RTimothyEdwards/sg13cmos5l_ocd_openframe/xschem/simulations/openframe_user_project.spice

** sch_path: /home/tim/gits/sg13cmos5l_ocd_openframe/xschem/openframe_user_project.sch
**.subckt openframe_user_project vddio vssio vccd vssd gpio0_ena gpio0_zero gpio0_out gpio1_ena gpio1_zero gpio1_out UART_Rx_zero
*+ UART_Rx_ena ref_in vbg UART_Rx_out UART_Tx_zero UART_Tx_ena UART_Tx_out spi_SDI_zero spi_SDI_ena spi_SDI_out test_source_ibias spi_CSB_zero
*+ spi_CSB_ena voltgen_vout1 spi_CSB_out idac1_source idac1_sink spi_SCK_zero spi_SCK_ena idac2_source voltgen_vout2 idac2_sink spi_SCK_out
*+ flash_csb_zero flash_csb_ena flash_csb_out flash_clk_ena flash_clk_zero flash_clk_out flash_io0_zero flash_io0_ena flash_io0_out resetb_in
*+ spi_SCK_in spi_SDO_out flash_io1_zero flash_io1_ena spi_SDI_in spi_CSB_in spi_SDO_ena flash_io1_out
*+ mask_rev[31],mask_rev[30],mask_rev[29],mask_rev[28],mask_rev[27],mask_rev[26],mask_rev[25],mask_rev[24],mask_rev[23],mask_rev[22],mask_rev[21],mask_rev[20],mask_rev[19],mask_rev[18],mask_rev[17],mask_rev[16],mask_rev[15],mask_rev[14],mask_rev[13],mask_rev[12],mask_rev[11],mask_rev[10],mask_rev[9],mask_rev[8],mask_rev[7],mask_rev[6],mask_rev[5],mask_rev[4],mask_rev[3],mask_rev[2],mask_rev[1],mask_rev[0] flash_io2_zero flash_io2_ena flash_io2_out flash_io3_zero flash_io3_ena flash_io3_out spi_SDO_one spi_SDO_zero flash_io3_one
*.iopin vddio
*.iopin vssio
*.iopin vccd
*.iopin vssd
*.ipin resetb_in
*.ipin
*+ mask_rev[31],mask_rev[30],mask_rev[29],mask_rev[28],mask_rev[27],mask_rev[26],mask_rev[25],mask_rev[24],mask_rev[23],mask_rev[22],mask_rev[21],mask_rev[20],mask_rev[19],mask_rev[18],mask_rev[17],mask_rev[16],mask_rev[15],mask_rev[14],mask_rev[13],mask_rev[12],mask_rev[11],mask_rev[10],mask_rev[9],mask_rev[8],mask_rev[7],mask_rev[6],mask_rev[5],mask_rev[4],mask_rev[3],mask_rev[2],mask_rev[1],mask_rev[0]
*.opin spi_SDO_out
*.opin spi_SDO_ena
*.opin spi_SDI_ena
*.opin spi_SDI_out
*.ipin spi_SDI_zero
*.ipin spi_SDI_in
*.opin spi_CSB_ena
*.opin spi_CSB_out
*.ipin spi_CSB_zero
*.ipin spi_CSB_in
*.opin spi_SCK_ena
*.opin spi_SCK_out
*.ipin spi_SCK_zero
*.ipin spi_SCK_in
*.opin vbg
*.ipin ref_in
*.ipin idac1_sink
*.ipin idac2_sink
*.opin idac1_source
*.opin idac2_source
*.opin test_source_ibias
*.opin voltgen_vout1
*.opin voltgen_vout2
*.ipin spi_SDO_one
*.ipin spi_SDO_zero
*.ipin flash_io3_one
*.opin gpio1_ena
*.opin gpio1_out
*.ipin gpio1_zero
*.opin UART_Rx_ena
*.opin UART_Rx_out
*.ipin UART_Rx_zero
*.opin UART_Tx_ena
*.opin UART_Tx_out
*.ipin UART_Tx_zero
*.opin gpio0_ena
*.opin gpio0_out
*.ipin gpio0_zero
*.opin flash_csb_ena
*.opin flash_csb_out
*.ipin flash_csb_zero
*.opin flash_clk_ena
*.opin flash_clk_out
*.ipin flash_clk_zero
*.opin flash_io0_ena
*.opin flash_io0_out
*.ipin flash_io0_zero
*.opin flash_io1_ena
*.opin flash_io1_out
*.ipin flash_io1_zero
*.opin flash_io2_ena
*.opin flash_io2_out
*.ipin flash_io2_zero
*.opin flash_io3_ena
*.opin flash_io3_out
*.ipin flash_io3_zero
x1 control[80] vddio vssio vssd vccd vdda7 power_stage
x2 control[79] vddio vssio vssd vccd vdda6 power_stage
x3 control[78] vddio vssio vssd vccd vdda5 power_stage
x4 control[77] vddio vssio vssd vccd vdda4 power_stage
x5 control[76] vddio vssio vssd vccd vdda3 power_stage
x6 control[75] vddio vssio vssd vccd vdda2 power_stage
x7 control[74] vddio vssio vssd vccd vdda1 power_stage
x8 control[21] vddio vssio vssd vccd vdda10 power_stage
x9 control[22] vddio vssio vssd vccd vdda11 power_stage
x10 control[23] vddio vssio vssd vccd vdda12 power_stage
x11 control[24] vddio vssio vssd vccd vdda13 power_stage
x12 control[25] vddio vssio vssd vccd vdda14 power_stage
x13 control[26] vddio vssio vssd vccd vdda15 power_stage
x14 control[27] vddio vssio vssd vccd vdda16 power_stage
x15 vdda12 vbg vssio net2 control[29] control[30] control[31] control[32] control[33] control[34] control[35] control[36]
+ control[37] control[38] control[39] control[40] control[41] control[42] control[43] control[44] vssd vccd control[28] net1
+ sg13cmos5l_ocd_ip__bandgap
x16 control[88] vddio vssio ref_in vccd vbg control[87] vssd net1 control[71] control[72] control[73] control[82] control[83]
+ control[107] control[106] control[105] control[104] control[103] control[58] control[59] control[60] control[61] control[62] net2 control[45]
+ control[46] control[47] control[48] control[49] control[121] control[120] control[119] control[118] control[117] net5 control[94] control[93]
+ control[92] control[91] control[90] test_source_ibias control[63] control[64] control[65] control[66] control[67] control[68] control[69]
+ control[70] net3 net4 idac1_source idac2_source control[102] control[101] control[100] control[99] control[98] control[97] control[96]
+ control[95] control[50] control[51] control[52] control[53] control[54] control[55] control[56] control[57] control[115] control[114]
+ control[113] control[112] control[111] control[110] control[109] control[108] idac1_sink idac2_sink control[86] control[85]
+ sg13cmos5l_ocd_ip__biasgen1
x17 vccd vssd vdda5 control[116] control[122] control[123] vbg vssio net5 voltgen_vout2 net3 control[124] voltgen_vout1
+ control[126] control[125] net4 control[127] sg13cmos5l_ocd_ip__voltgen
x18 spi_SDI_in mask_rev[31] mask_rev[30] mask_rev[29] mask_rev[28] mask_rev[27] mask_rev[26] mask_rev[25] mask_rev[24]
+ mask_rev[23] mask_rev[22] mask_rev[21] mask_rev[20] mask_rev[19] mask_rev[18] mask_rev[17] mask_rev[16] mask_rev[15] mask_rev[14] mask_rev[13]
+ mask_rev[12] mask_rev[11] mask_rev[10] mask_rev[9] mask_rev[8] mask_rev[7] mask_rev[6] mask_rev[5] mask_rev[4] mask_rev[3] mask_rev[2]
+ mask_rev[1] mask_rev[0] spi_CSB_in flash_io3_zero flash_io3_zero flash_io3_zero flash_io3_zero flash_io3_zero flash_io3_zero flash_io3_zero
+ flash_io3_zero flash_io3_zero flash_io3_zero flash_io3_zero flash_io3_zero flash_io3_zero flash_io3_zero flash_io3_zero flash_io3_zero
+ flash_io3_zero flash_io3_zero flash_io3_zero flash_io3_zero flash_io3_zero flash_io3_zero flash_io3_zero flash_io3_zero flash_io3_zero
+ flash_io3_zero flash_io3_zero flash_io3_zero flash_io3_zero flash_io3_zero flash_io3_zero flash_io3_zero flash_io3_one flash_io3_one
+ flash_io3_one flash_io3_one flash_io3_one flash_io3_one flash_io3_one flash_io3_one flash_io3_one flash_io3_one flash_io3_one flash_io3_one
+ flash_io3_one flash_io3_one flash_io3_one flash_io3_one flash_io3_one flash_io3_one flash_io3_one flash_io3_one flash_io3_one flash_io3_one
+ flash_io3_one flash_io3_one flash_io3_one flash_io3_one flash_io3_one flash_io3_one flash_io3_one flash_io3_one flash_io3_one flash_io3_one
+ spi_SDO_zero spi_SDO_zero spi_SDO_zero spi_SDO_zero spi_SDO_zero spi_SDO_zero spi_SDO_zero spi_SDO_zero spi_SDO_zero spi_SDO_zero spi_SDO_zero
+ spi_SDO_zero spi_SDO_zero spi_SDO_zero spi_SDO_zero spi_SDO_zero spi_SDO_zero spi_SDO_zero spi_SDO_zero spi_SDO_zero spi_SDO_zero spi_SDO_zero
+ spi_SDO_zero spi_SDO_zero spi_SDO_zero spi_SDO_zero spi_SDO_zero spi_SDO_zero spi_SDO_zero spi_SDO_zero spi_SDO_zero spi_SDO_zero spi_SDO_one
+ spi_SDO_one spi_SDO_one spi_SDO_one spi_SDO_one spi_SDO_one spi_SDO_one spi_SDO_one spi_SDO_one spi_SDO_one spi_SDO_one spi_SDO_one
+ spi_SDO_one spi_SDO_one spi_SDO_one spi_SDO_one spi_SDO_one spi_SDO_one spi_SDO_one spi_SDO_one spi_SDO_one spi_SDO_one spi_SDO_one
+ spi_SDO_one spi_SDO_one spi_SDO_one spi_SDO_one spi_SDO_one spi_SDO_one spi_SDO_one spi_SDO_one spi_SDO_one spi_SDO_out spi_SDO_ena vccd vssd
+ resetb_in net6 spi_SCK_in control[127] control[126] control[125] control[124] control[123] control[122] control[121] control[120]
+ control[119] control[118] control[117] control[116] control[115] control[114] control[113] control[112] control[111] control[110] control[109]
+ control[108] control[107] control[106] control[105] control[104] control[103] control[102] control[101] control[100] control[99] control[98]
+ control[97] control[96] control[95] control[94] control[93] control[92] control[91] control[90] control[89] control[88] control[87]
+ control[86] control[85] control[84] control[83] control[82] control[81] control[80] control[79] control[78] control[77] control[76]
+ control[75] control[74] control[73] control[72] control[71] control[70] control[69] control[68] control[67] control[66] control[65]
+ control[64] control[63] control[62] control[61] control[60] control[59] control[58] control[57] control[56] control[55] control[54]
+ control[53] control[52] control[51] control[50] control[49] control[48] control[47] control[46] control[45] control[44] control[43]
+ control[42] control[41] control[40] control[39] control[38] control[37] control[36] control[35] control[34] control[33] control[32]
+ control[31] control[30] control[29] control[28] control[27] control[26] control[25] control[24] control[23] control[22] control[21]
+ control[20] control[19] control[18] control[17] control[16] control[15] control[14] control[13] control[12] control[11] control[10]
+ control[9] control[8] control[7] control[6] control[5] control[4] control[3] control[2] control[1] control[0] housekeeping_top
* noconn #net6
* noconn control[19:0]
* noconn control[89]
* noconn control[84]
R1 gpio1_ena gpio1_zero 0.0293 m=1
R2 gpio1_out gpio1_zero 0.0293 m=1
R3 UART_Rx_ena UART_Rx_zero 0.0293 m=1
R4 UART_Rx_out UART_Rx_zero 0.0293 m=1
R5 UART_Tx_ena UART_Tx_zero 0.0293 m=1
R6 UART_Tx_out UART_Tx_zero 0.0293 m=1
R7 spi_SDI_ena spi_SDI_zero 0.0293 m=1
R8 spi_SDI_out spi_SDI_zero 0.0293 m=1
R9 spi_CSB_ena spi_CSB_zero 0.0293 m=1
R10 spi_CSB_out spi_CSB_zero 0.0293 m=1
R11 spi_SCK_ena spi_SCK_zero 0.0293 m=1
R12 spi_SCK_out spi_SCK_zero 0.0293 m=1
x19 control[81] vddio vssio vssd vccd vdda8 power_stage
x20 control[20] vddio vssio vssd vccd vdda9 power_stage
R13 gpio0_ena gpio0_zero 0.0293 m=1
R14 gpio0_out gpio0_zero 0.0293 m=1
R15 flash_csb_ena flash_csb_zero 0.0293 m=1
R16 flash_csb_out flash_csb_zero 0.0293 m=1
R17 flash_clk_ena flash_clk_zero 0.0293 m=1
R18 flash_clk_out flash_clk_zero 0.0293 m=1
R19 flash_io0_ena flash_io0_zero 0.0293 m=1
R20 flash_io0_out flash_io0_zero 0.0293 m=1
R21 flash_io1_ena flash_io1_zero 0.0293 m=1
R22 flash_io1_out flash_io1_zero 0.0293 m=1
R23 flash_io2_ena flash_io2_zero 0.0293 m=1
R24 flash_io2_out flash_io2_zero 0.0293 m=1
R25 flash_io3_ena flash_io3_zero 0.0293 m=1
R26 flash_io3_out flash_io3_zero 0.0293 m=1
**.ends

* expanding   symbol:  power_stage.sym # of pins=6
** sym_path: /home/tim/gits/sg13cmos5l_ocd_openframe/dependencies/sg13cmos5l_ocd_ip__analog_switches/xschem/power_stage.sym
** sch_path: /home/tim/gits/sg13cmos5l_ocd_openframe/dependencies/sg13cmos5l_ocd_ip__analog_switches/xschem/power_stage.sch
.subckt power_stage enable IOVDD_IN IOVSS DVSS DVDD IOVDD_OUT
*.ipin enable
*.ipin IOVDD_IN
*.ipin DVSS
*.ipin DVDD
*.ipin IOVSS
*.opin IOVDD_OUT
XM14 IOVDD_OUT P_DRIVE IOVDD_IN IOVDD_IN sg13_hv_pmos w=4.36u l=0.4u ng=1 m=760
x2 net1 net2 P_DRIVE IOVDD_IN IOVSS gate_drive
x1 net1 enable DVDD DVSS sg13cmos5l_inv_4
x3 net2 net1 DVDD DVSS sg13cmos5l_inv_4
x4[1] DVDD DVSS sg13cmos5l_decap_4
x4[0] DVDD DVSS sg13cmos5l_decap_4
x9 enable DVDD DVSS sg13cmos5l_antennanp
.ends


* expanding   symbol:  sg13cmos5l_ocd_ip__bandgap.sym # of pins=9
** sym_path: /home/tim/gits/sg13cmos5l_ocd_openframe/dependencies/sg13cmos5l_ocd_ip__biasgen/xschem/sg13cmos5l_ocd_ip__bandgap.sym
** sch_path: /home/tim/gits/sg13cmos5l_ocd_openframe/dependencies/sg13cmos5l_ocd_ip__biasgen/xschem/sg13cmos5l_ocd_ip__bandgap.sch
.subckt sg13cmos5l_ocd_ip__bandgap vdd vbg vss ibias1_250n trim[15] trim[14] trim[13] trim[12] trim[11] trim[10] trim[9] trim[8]
+ trim[7] trim[6] trim[5] trim[4] trim[3] trim[2] trim[1] trim[0] dvss dvdd ena ibias2_1u
*.ipin
*+ trim[15],trim[14],trim[13],trim[12],trim[11],trim[10],trim[9],trim[8],trim[7],trim[6],trim[5],trim[4],trim[3],trim[2],trim[1],trim[0]
*.ipin ena
*.opin vbg
*.iopin ibias2_1u
*.iopin ibias1_250n
*.iopin vdd
*.iopin dvdd
*.iopin dvss
*.iopin vss
x1 vdd vbg_unbuf vss ibias1_250n trim[15] trim[14] trim[13] trim[12] trim[11] trim[10] trim[9] trim[8] trim[7] trim[6] trim[5]
+ trim[4] trim[3] trim[2] trim[1] trim[0] dvss dvdd ena ena_b_h bandgap_unbuffered
x2 vdd vbg vbg_unbuf vbg vss ibias2_1u ena_b_h se_folded_cascode_np_ab
.ends


* expanding   symbol:  sg13cmos5l_ocd_ip__biasgen1.sym # of pins=30
** sym_path: /home/tim/gits/sg13cmos5l_ocd_openframe/dependencies/sg13cmos5l_ocd_ip__biasgen/xschem/sg13cmos5l_ocd_ip__biasgen1.sym
** sch_path: /home/tim/gits/sg13cmos5l_ocd_openframe/dependencies/sg13cmos5l_ocd_ip__biasgen/xschem/sg13cmos5l_ocd_ip__biasgen1.sch
.subckt sg13cmos5l_ocd_ip__biasgen1 ena avdd avss ref_in dvdd vbg ref_sel_vbg dvss bandgap_source_ibias bandgap_source[4]
+ bandgap_source[3] bandgap_source[2] bandgap_source[1] bandgap_source[0] bandgap_sink[4] bandgap_sink[3] bandgap_sink[2] bandgap_sink[1]
+ bandgap_sink[0] voltgen_source1[4] voltgen_source1[3] voltgen_source1[2] voltgen_source1[1] voltgen_source1[0] bandgap_sink_ibias
+ voltgen_source2[4] voltgen_source2[3] voltgen_source2[2] voltgen_source2[1] voltgen_source2[0] voltgen_sink[4] voltgen_sink[3] voltgen_sink[2]
+ voltgen_sink[1] voltgen_sink[0] voltgen_source1_ibias test_sink[4] test_sink[3] test_sink[2] test_sink[1] test_sink[0] voltgen_source2_ibias
+ idac1_source[7] idac1_source[6] idac1_source[5] idac1_source[4] idac1_source[3] idac1_source[2] idac1_source[1] idac1_source[0]
+ voltgen_sink_ibias test_sink_ibias idac1_source idac2_source idac1_sink[7] idac1_sink[6] idac1_sink[5] idac1_sink[4] idac1_sink[3] idac1_sink[2]
+ idac1_sink[1] idac1_sink[0] idac2_source[7] idac2_source[6] idac2_source[5] idac2_source[4] idac2_source[3] idac2_source[2] idac2_source[1]
+ idac2_source[0] idac2_sink[7] idac2_sink[6] idac2_sink[5] idac2_sink[4] idac2_sink[3] idac2_sink[2] idac2_sink[1] idac2_sink[0] idac1_sink
+ idac2_sink ref_sel_coarse ref_sel_fine
*.iopin avdd
*.iopin avss
*.iopin dvdd
*.iopin dvss
*.ipin ena
*.ipin ref_in
*.ipin vbg
*.ipin ref_sel_vbg
*.ipin bandgap_sink[4],bandgap_sink[3],bandgap_sink[2],bandgap_sink[1],bandgap_sink[0]
*.ipin voltgen_sink[4],voltgen_sink[3],voltgen_sink[2],voltgen_sink[1],voltgen_sink[0]
*.ipin test_sink[4],test_sink[3],test_sink[2],test_sink[1],test_sink[0]
*.ipin idac1_sink[7],idac1_sink[6],idac1_sink[5],idac1_sink[4],idac1_sink[3],idac1_sink[2],idac1_sink[1],idac1_sink[0]
*.ipin idac2_sink[7],idac2_sink[6],idac2_sink[5],idac2_sink[4],idac2_sink[3],idac2_sink[2],idac2_sink[1],idac2_sink[0]
*.iopin bandgap_sink_ibias
*.iopin voltgen_sink_ibias
*.iopin test_sink_ibias
*.iopin idac1_sink
*.iopin idac2_sink
*.ipin ref_sel_fine
*.ipin ref_sel_coarse
*.iopin bandgap_source_ibias
*.iopin voltgen_source1_ibias
*.iopin voltgen_source2_ibias
*.iopin idac1_source
*.iopin idac2_source
*.ipin bandgap_source[4],bandgap_source[3],bandgap_source[2],bandgap_source[1],bandgap_source[0]
*.ipin voltgen_source1[4],voltgen_source1[3],voltgen_source1[2],voltgen_source1[1],voltgen_source1[0]
*.ipin voltgen_source2[4],voltgen_source2[3],voltgen_source2[2],voltgen_source2[1],voltgen_source2[0]
*.ipin
*+ idac1_source[7],idac1_source[6],idac1_source[5],idac1_source[4],idac1_source[3],idac1_source[2],idac1_source[1],idac1_source[0]
*.ipin
*+ idac2_source[7],idac2_source[6],idac2_source[5],idac2_source[4],idac2_source[3],idac2_source[2],idac2_source[1],idac2_source[0]
x1 avdd ena vbg net1 avss dvdd dvss ref_sel_vbg ref_in dvss nbias pcasc pbias net2 dvss ncasc ref_sel_fine ref_sel_coarse avdd
+ bias_generator_fe
* noconn #net1
* noconn #net2
x12 dvdd dvss avdd nbias avss bandgap_sink[4] bandgap_sink[3] bandgap_sink[2] bandgap_sink[1] bandgap_sink[0] bandgap_sink_ibias
+ ncasc avss avss bias_generator_be0n
x13 dvdd dvss avdd pcasc pbias bandgap_source[4] bandgap_source[3] bandgap_source[2] bandgap_source[1] bandgap_source[0]
+ bandgap_source_ibias avss avdd avdd avdd bias_generator_be0p
x14 dvdd dvss avdd nbias avss idac1_sink[7] idac1_sink[6] idac1_sink[5] idac1_sink[4] idac1_sink[3] idac1_sink[2] idac1_sink[1]
+ idac1_sink[0] idac1_sink ncasc avss avss bias_generator_be1n
x15 dvdd dvss avdd pcasc pbias idac2_source[7] idac2_source[6] idac2_source[5] idac2_source[4] idac2_source[3] idac2_source[2]
+ idac2_source[1] idac2_source[0] idac2_source avss avdd avdd avdd bias_generator_be1p
x2 dvdd dvss avdd nbias avss voltgen_sink[4] voltgen_sink[3] voltgen_sink[2] voltgen_sink[1] voltgen_sink[0] voltgen_sink_ibias
+ ncasc avss avss bias_generator_be0n
x4 dvdd dvss avdd nbias avss test_sink[4] test_sink[3] test_sink[2] test_sink[1] test_sink[0] test_sink_ibias ncasc avss avss
+ bias_generator_be0n
x3 dvdd dvss avdd nbias avss idac2_sink[7] idac2_sink[6] idac2_sink[5] idac2_sink[4] idac2_sink[3] idac2_sink[2] idac2_sink[1]
+ idac2_sink[0] idac2_sink ncasc avss avss bias_generator_be1n
x5 dvdd dvss avdd pcasc pbias voltgen_source1[4] voltgen_source1[3] voltgen_source1[2] voltgen_source1[1] voltgen_source1[0]
+ voltgen_source1_ibias avss avdd avdd avdd bias_generator_be0p
x6 dvdd dvss avdd pcasc pbias voltgen_source2[4] voltgen_source2[3] voltgen_source2[2] voltgen_source2[1] voltgen_source2[0]
+ voltgen_source2_ibias avss avdd avdd avdd bias_generator_be0p
x7 dvdd dvss avdd pcasc pbias idac1_source[7] idac1_source[6] idac1_source[5] idac1_source[4] idac1_source[3] idac1_source[2]
+ idac1_source[1] idac1_source[0] idac1_source avss avdd avdd avdd bias_generator_be1p
x8[11] net4 avss ncasc nbias avss avss avss bias_nstack
x8[10] net4 avss ncasc nbias avss avss avss bias_nstack
x8[9] net4 avss ncasc nbias avss avss avss bias_nstack
x8[8] net4 avss ncasc nbias avss avss avss bias_nstack
x8[7] net4 avss ncasc nbias avss avss avss bias_nstack
x8[6] net4 avss ncasc nbias avss avss avss bias_nstack
x8[5] net4 avss ncasc nbias avss avss avss bias_nstack
x8[4] net4 avss ncasc nbias avss avss avss bias_nstack
x8[3] net4 avss ncasc nbias avss avss avss bias_nstack
x8[2] net4 avss ncasc nbias avss avss avss bias_nstack
x8[1] net4 avss ncasc nbias avss avss avss bias_nstack
x8[0] net4 avss ncasc nbias avss avss avss bias_nstack
x9[11] avdd pbias pcasc avdd net3 avdd avdd bias_pstack
x9[10] avdd pbias pcasc avdd net3 avdd avdd bias_pstack
x9[9] avdd pbias pcasc avdd net3 avdd avdd bias_pstack
x9[8] avdd pbias pcasc avdd net3 avdd avdd bias_pstack
x9[7] avdd pbias pcasc avdd net3 avdd avdd bias_pstack
x9[6] avdd pbias pcasc avdd net3 avdd avdd bias_pstack
x9[5] avdd pbias pcasc avdd net3 avdd avdd bias_pstack
x9[4] avdd pbias pcasc avdd net3 avdd avdd bias_pstack
x9[3] avdd pbias pcasc avdd net3 avdd avdd bias_pstack
x9[2] avdd pbias pcasc avdd net3 avdd avdd bias_pstack
x9[1] avdd pbias pcasc avdd net3 avdd avdd bias_pstack
x9[0] avdd pbias pcasc avdd net3 avdd avdd bias_pstack
* noconn #net4
* noconn #net3
.ends


* expanding   symbol:  sg13cmos5l_ocd_ip__voltgen.sym # of pins=15
** sym_path: /home/tim/gits/sg13cmos5l_ocd_openframe/dependencies/sg13cmos5l_ocd_ip__biasgen/xschem/sg13cmos5l_ocd_ip__voltgen.sym
** sch_path: /home/tim/gits/sg13cmos5l_ocd_openframe/dependencies/sg13cmos5l_ocd_ip__biasgen/xschem/sg13cmos5l_ocd_ip__voltgen.sch
.subckt sg13cmos5l_ocd_ip__voltgen dvdd dvss vdd s[2] s[1] s[0] vbg vss ibias1u_1 vout2 ibias1u_2 ena vout1 ena1 ena2 ibias1u_3
+ high
*.iopin vdd
*.iopin vss
*.ipin vbg
*.opin vout1
*.iopin ibias1u_1
*.ipin s[2],s[1],s[0]
*.iopin ibias1u_2
*.iopin dvdd
*.iopin dvss
*.ipin ena
*.opin vout2
*.iopin ibias1u_3
*.ipin ena1
*.ipin ena2
*.ipin high
C1 vdd net1 1.64p m=1
XM1 vref7 net1 vdd vdd sg13_hv_pmos w=2u l=0.5u ng=1 m=1
XR1 vref7 vref6 vss rhigh w=0.5e-6 l=2.5e-6 m=1 b=0
XR2 vref6 vref5 vss rhigh w=0.5e-6 l=2.5e-6 m=1 b=0
XR3 vref5 vref4 vss rhigh w=0.5e-6 l=2.5e-6 m=1 b=0
XR4 vref4 vref3 vss rhigh w=0.5e-6 l=2.5e-6 m=1 b=0
XR5 vref3 vref2 vss rhigh w=0.5e-6 l=2.5e-6 m=1 b=0
XR6 vref2 vref1 vss rhigh w=0.5e-6 l=2.5e-6 m=1 b=0
XR7 vref1 vref0 vss rhigh w=0.5e-6 l=2.5e-6 m=1 b=0
XR8 vref0 vss vss rhigh w=0.5e-6 l=2.5e-6 m=1 b=0
x2 v7b vdd vref7 vpre vss v7 xgate
x3 vdd v0 v0b vss hv_inv_1
x4 v6b vdd vref6 vpre vss v6 xgate
x5 v5b vdd vref5 vpre vss v5 xgate
x6 v4b vdd vref4 vpre vss v4 xgate
x7 v3b vdd vref3 vpre vss v3 xgate
x8 v2b vdd vref2 vpre vss v2 xgate
x9 v1b vdd vref1 vpre vss v1 xgate
x10 v0b vdd vref0 vpre vss v0 xgate
x11 net3 net2 v0 vdd vss level_shift
x12 net2 net3 dvdd dvss sg13cmos5l_inv_2
x13 net3 s2b s1b s0b dvdd dvss sg13cmos5l_nand3_1
x14 s0b s[0] dvdd dvss sg13cmos5l_inv_2
x15 s1b s[1] dvdd dvss sg13cmos5l_inv_2
x16 s2b s[2] dvdd dvss sg13cmos5l_inv_2
x17 s0 s0b dvdd dvss sg13cmos5l_inv_2
x18 s1 s1b dvdd dvss sg13cmos5l_inv_2
x19 s2 s2b dvdd dvss sg13cmos5l_inv_2
x20 vdd v1 v1b vss hv_inv_1
x21 net5 net4 v1 vdd vss level_shift
x22 net4 net5 dvdd dvss sg13cmos5l_inv_2
x23 net5 s2b s1b s0 dvdd dvss sg13cmos5l_nand3_1
x24 vdd v2 v2b vss hv_inv_1
x25 net7 net6 v2 vdd vss level_shift
x26 net6 net7 dvdd dvss sg13cmos5l_inv_2
x27 net7 s2b s1 s0b dvdd dvss sg13cmos5l_nand3_1
x28 vdd v3 v3b vss hv_inv_1
x29 net9 net8 v3 vdd vss level_shift
x30 net8 net9 dvdd dvss sg13cmos5l_inv_2
x31 net9 s2b s1 s0 dvdd dvss sg13cmos5l_nand3_1
x32 vdd v4 v4b vss hv_inv_1
x33 net11 net10 v4 vdd vss level_shift
x34 net10 net11 dvdd dvss sg13cmos5l_inv_2
x35 net11 s2 s1b s0b dvdd dvss sg13cmos5l_nand3_1
x36 vdd v5 v5b vss hv_inv_1
x37 net13 net12 v5 vdd vss level_shift
x38 net12 net13 dvdd dvss sg13cmos5l_inv_2
x39 net13 s2 s1b s0 dvdd dvss sg13cmos5l_nand3_1
x40 vdd v6 v6b vss hv_inv_1
x41 net15 net14 v6 vdd vss level_shift
x42 net14 net15 dvdd dvss sg13cmos5l_inv_2
x43 net15 s2 s1 s0b dvdd dvss sg13cmos5l_nand3_1
x44 vdd v7 v7b vss hv_inv_1
x45 net17 net16 v7 vdd vss level_shift
x46 net16 net17 dvdd dvss sg13cmos5l_inv_2
x47 net17 s2 s1 s0 dvdd dvss sg13cmos5l_nand3_1
x50 vdd vout1 vout1 vpre ibias1u_2 vss vgen_ena1_b_h p_amp_large
x1 net19 ena vgen_ena_h vdd vss level_shift
x51 net19 ena dvdd dvss sg13cmos5l_inv_2
x48 vdd net1 vbg net18 ibias1u_1 vss vgen_ena_h n_amp_large
x52 vdd vout2 vpre vout2 vss ibias1u_3 vgen_ena2_b_h se_folded_cascode_p
x49 ena1 net20 vgen_ena1_b_h vdd vss level_shift
x53 net20 ena1 dvdd dvss sg13cmos5l_inv_2
x54 ena2 net21 vgen_ena2_b_h vdd vss level_shift
x55 net21 ena2 dvdd dvss sg13cmos5l_inv_2
x56 high_h vdd net18 vref3 vss low_h xgate
x57 low_h vdd net18 vref2 vss high_h xgate
x58 net22 high high_h vdd vss level_shift
x59 net22 high dvdd dvss sg13cmos5l_inv_2
x60 vdd high_h low_h vss hv_inv_1
XR9 vss vss vss rhigh w=0.5e-6 l=2.5e-6 m=1 b=0
XR10 vss vss vss rhigh w=0.5e-6 l=2.5e-6 m=1 b=0
x67 s[0] dvdd dvss sg13cmos5l_antennanp
x68 dvdd dvss sg13cmos5l_decap_4
x61 s[1] dvdd dvss sg13cmos5l_antennanp
x62 s[2] dvdd dvss sg13cmos5l_antennanp
x63 high dvdd dvss sg13cmos5l_antennanp
x64 ena dvdd dvss sg13cmos5l_antennanp
x65 ena1 dvdd dvss sg13cmos5l_antennanp
x66 ena2 dvdd dvss sg13cmos5l_antennanp
.ends


* expanding   symbol:  gate_drive.sym # of pins=5
** sym_path: /home/tim/gits/sg13cmos5l_ocd_openframe/dependencies/sg13cmos5l_ocd_ip__analog_switches/xschem/gate_drive.sym
** sch_path: /home/tim/gits/sg13cmos5l_ocd_openframe/dependencies/sg13cmos5l_ocd_ip__analog_switches/xschem/gate_drive.sch
.subckt gate_drive in_n in_p out vdd vss
*.ipin in_n
*.ipin in_p
*.ipin vdd
*.ipin vss
*.opin out
XM1 net1 in_p vss vss sg13_hv_nmos w=2u l=0.5u ng=1 m=2
XM2 net1 S1_N vdd vdd sg13_hv_pmos w=4u l=0.5u ng=1 m=2
XM3 S1_N in_n vss vss sg13_hv_nmos w=2u l=0.5u ng=1 m=2
XM4 S1_N net1 vdd vdd sg13_hv_pmos w=4u l=0.5u ng=1 m=2
XM5 S2_N S1_N vdd vdd sg13_hv_pmos w=10u l=0.5u ng=1 m=2
XM6 S2_N S1_N vss vss sg13_hv_nmos w=5u l=0.5u ng=1 m=2
XM7 S3_N S2_N vdd vdd sg13_hv_pmos w=10u l=0.5u ng=1 m=6
XM8 S3_N S2_N vss vss sg13_hv_nmos w=5u l=0.5u ng=1 m=6
XM9 S4_N S3_N vdd vdd sg13_hv_pmos w=10u l=0.5u ng=1 m=20
XM10 S4_N S3_N vss vss sg13_hv_nmos w=5u l=0.5u ng=1 m=20
XM11 out S4_N vdd vdd sg13_hv_pmos w=10u l=0.5u ng=1 m=60
XM12 out S4_N vss vss sg13_hv_nmos w=5u l=0.5u ng=1 m=60
.ends


* expanding   symbol:  bandgap_unbuffered.sym # of pins=9
** sym_path: /home/tim/gits/sg13cmos5l_ocd_openframe/dependencies/sg13cmos5l_ocd_ip__biasgen/xschem/bandgap_unbuffered.sym
** sch_path: /home/tim/gits/sg13cmos5l_ocd_openframe/dependencies/sg13cmos5l_ocd_ip__biasgen/xschem/bandgap_unbuffered.sch
.subckt bandgap_unbuffered vdd vbg vss bias trim[15] trim[14] trim[13] trim[12] trim[11] trim[10] trim[9] trim[8] trim[7] trim[6]
+ trim[5] trim[4] trim[3] trim[2] trim[1] trim[0] dvss dvdd ena ena_b_h
*.iopin vdd
*.iopin vss
*.opin vbg
*.iopin bias
*.ipin
*+ trim[15],trim[14],trim[13],trim[12],trim[11],trim[10],trim[9],trim[8],trim[7],trim[6],trim[5],trim[4],trim[3],trim[2],trim[1],trim[0]
*.iopin dvss
*.iopin dvdd
*.ipin ena
*.opin ena_b_h
XQ2 vss vss net2 pnpMPA a=1.4e-12 p=5.4e-06 m=8
XQ1 vss vss vn pnpMPA a=1.4e-12 p=5.4e-06 m=1
C1 gate vss 1.69p m=1
xres vbg comp vp vn vss net1 vss vss vp vss vss bg_res
XM1 comp gate vdd vdd sg13_hv_pmos w=4u l=1u ng=1 m=2
XM2 vbg gate vdd vdd sg13_hv_pmos w=4u l=1u ng=1 m=2
xtr net1 net2 net4[15] net4[14] net4[13] net4[12] net4[11] net4[10] net4[9] net4[8] net4[7] net4[6] net4[5] net4[4] net4[3]
+ net4[2] net4[1] net4[0] vss bg_trim
xamp vdd gate vp vn vss bias ena_b_h se_folded_cascode_p
XM3 vs1 vbg vss vss sg13_hv_nmos w=1u l=1u ng=1 m=1
XM4 gate vs1 vss vss sg13_hv_nmos w=1u l=1u ng=1 m=1
XM5 vs1 vs2 vdd vdd sg13_hv_pmos w=1u l=1u ng=1 m=1
C2 vs2 vss 440.32f m=1
XM6 vs2 vs2 vdd vdd sg13_hv_pmos w=1u l=1u ng=1 m=1
XM7 vss vdd vs2 vs2 sg13_hv_pmos w=1u l=1u ng=1 m=1
x1[15] net3[15] trim[15] net4[15] vdd vss level_shift
x1[14] net3[14] trim[14] net4[14] vdd vss level_shift
x1[13] net3[13] trim[13] net4[13] vdd vss level_shift
x1[12] net3[12] trim[12] net4[12] vdd vss level_shift
x1[11] net3[11] trim[11] net4[11] vdd vss level_shift
x1[10] net3[10] trim[10] net4[10] vdd vss level_shift
x1[9] net3[9] trim[9] net4[9] vdd vss level_shift
x1[8] net3[8] trim[8] net4[8] vdd vss level_shift
x1[7] net3[7] trim[7] net4[7] vdd vss level_shift
x1[6] net3[6] trim[6] net4[6] vdd vss level_shift
x1[5] net3[5] trim[5] net4[5] vdd vss level_shift
x1[4] net3[4] trim[4] net4[4] vdd vss level_shift
x1[3] net3[3] trim[3] net4[3] vdd vss level_shift
x1[2] net3[2] trim[2] net4[2] vdd vss level_shift
x1[1] net3[1] trim[1] net4[1] vdd vss level_shift
x1[0] net3[0] trim[0] net4[0] vdd vss level_shift
x2[15] net3[15] trim[15] dvdd dvss sg13cmos5l_inv_2
x2[14] net3[14] trim[14] dvdd dvss sg13cmos5l_inv_2
x2[13] net3[13] trim[13] dvdd dvss sg13cmos5l_inv_2
x2[12] net3[12] trim[12] dvdd dvss sg13cmos5l_inv_2
x2[11] net3[11] trim[11] dvdd dvss sg13cmos5l_inv_2
x2[10] net3[10] trim[10] dvdd dvss sg13cmos5l_inv_2
x2[9] net3[9] trim[9] dvdd dvss sg13cmos5l_inv_2
x2[8] net3[8] trim[8] dvdd dvss sg13cmos5l_inv_2
x2[7] net3[7] trim[7] dvdd dvss sg13cmos5l_inv_2
x2[6] net3[6] trim[6] dvdd dvss sg13cmos5l_inv_2
x2[5] net3[5] trim[5] dvdd dvss sg13cmos5l_inv_2
x2[4] net3[4] trim[4] dvdd dvss sg13cmos5l_inv_2
x2[3] net3[3] trim[3] dvdd dvss sg13cmos5l_inv_2
x2[2] net3[2] trim[2] dvdd dvss sg13cmos5l_inv_2
x2[1] net3[1] trim[1] dvdd dvss sg13cmos5l_inv_2
x2[0] net3[0] trim[0] dvdd dvss sg13cmos5l_inv_2
x3 ena net5 ena_b_h vdd vss level_shift
x4 net5 ena dvdd dvss sg13cmos5l_inv_2
x3[4] dvdd dvss sg13cmos5l_decap_4
x3[3] dvdd dvss sg13cmos5l_decap_4
x3[2] dvdd dvss sg13cmos5l_decap_4
x3[1] dvdd dvss sg13cmos5l_decap_4
x3[0] dvdd dvss sg13cmos5l_decap_4
x1 ena dvdd dvss sg13cmos5l_antennanp
x4[15] trim[15] dvdd dvss sg13cmos5l_antennanp
x4[14] trim[14] dvdd dvss sg13cmos5l_antennanp
x4[13] trim[13] dvdd dvss sg13cmos5l_antennanp
x4[12] trim[12] dvdd dvss sg13cmos5l_antennanp
x4[11] trim[11] dvdd dvss sg13cmos5l_antennanp
x4[10] trim[10] dvdd dvss sg13cmos5l_antennanp
x4[9] trim[9] dvdd dvss sg13cmos5l_antennanp
x4[8] trim[8] dvdd dvss sg13cmos5l_antennanp
x4[7] trim[7] dvdd dvss sg13cmos5l_antennanp
x4[6] trim[6] dvdd dvss sg13cmos5l_antennanp
x4[5] trim[5] dvdd dvss sg13cmos5l_antennanp
x4[4] trim[4] dvdd dvss sg13cmos5l_antennanp
x4[3] trim[3] dvdd dvss sg13cmos5l_antennanp
x4[2] trim[2] dvdd dvss sg13cmos5l_antennanp
x4[1] trim[1] dvdd dvss sg13cmos5l_antennanp
x4[0] trim[0] dvdd dvss sg13cmos5l_antennanp
C3 vs2 vss 203.19f m=1
.ends


* expanding   symbol:  se_folded_cascode_np_ab.sym # of pins=7
** sym_path: /home/tim/gits/sg13cmos5l_ocd_openframe/dependencies/sg13cmos5l_ocd_ip__biasgen/xschem/se_folded_cascode_np_ab.sym
** sch_path: /home/tim/gits/sg13cmos5l_ocd_openframe/dependencies/sg13cmos5l_ocd_ip__biasgen/xschem/se_folded_cascode_np_ab.sch
.subckt se_folded_cascode_np_ab vdd out inp inn vss bias ena_b
*.iopin vdd
*.iopin bias
*.ipin inp
*.ipin inn
*.iopin vss
*.opin out
*.ipin ena_b
XM4 outa1n outa1n vdd vdd sg13_hv_pmos w=1u l=1u ng=1 m=12
XM5 outa1p outa1n vdd vdd sg13_hv_pmos w=1u l=1u ng=1 m=12
XMIN1 diffa vbn1 vss vss sg13_hv_nmos w=1u l=1u ng=1 m=8
XMB2 vbn1 vbn1 vss vss sg13_hv_nmos w=1u l=1u ng=1 m=4
XMB1 vbn2 vbn2 vbn1 vss sg13_hv_nmos w=2u l=4u ng=1 m=4
XMIN2 outa1n inn diffa vss sg13_hv_nmos w=2u l=1u ng=1 m=8
XMIN3 outa1p inp diffa vss sg13_hv_nmos w=2u l=1u ng=1 m=8
XMB5 vbp1 vbp1 vdd vdd sg13_hv_pmos w=1u l=1u ng=1 m=4
XM7 outs1 mirr outa1p vdd sg13_hv_pmos w=1u l=4u ng=1 m=16
XM6 mirr mirr outa1n vdd sg13_hv_pmos w=1u l=4u ng=1 m=16
XM8 mirr vbn2 outb1n vss sg13_hv_nmos w=2u l=4u ng=1 m=16
XM9 outs1 vbn2 outb1p vss sg13_hv_nmos w=2u l=4u ng=1 m=16
XM10 outb1n vbn1 vss vss sg13_hv_nmos w=1u l=1u ng=1 m=24
XM11 outb1p vbn1 vss vss sg13_hv_nmos w=1u l=1u ng=1 m=24
XMB4 net1 net1 vbp1 vdd sg13_hv_pmos w=1u l=4u ng=1 m=4
XMIP2 outb1n inn diffb vdd sg13_hv_pmos w=4u l=1u ng=1 m=8
XMIP3 outb1p inp diffb vdd sg13_hv_pmos w=4u l=1u ng=1 m=8
XMIP1 diffb vbp1 vdd vdd sg13_hv_pmos w=1u l=1u ng=1 m=16
XMON out outs1 vss vss sg13_hv_nmos w=4u l=4u ng=1 m=4
XMOP out outs1 vdd vdd sg13_hv_pmos w=4u l=4u ng=1 m=4
C1[1] out outs1 1.30p m=1
C1[0] out outs1 1.30p m=1
XMB6 vbn2 vbp1 vdd vdd sg13_hv_pmos w=1u l=1u ng=1 m=4
XMB3 bias ena_b net1 vdd sg13_hv_pmos w=1u l=4u ng=1 m=4
XMDUM vss vss vss vss sg13_hv_nmos w=1u l=1u ng=1 m=12
XMB7 vss vbn2 vss vss sg13_hv_nmos w=2u l=4u ng=1 m=4
.ends
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
