RTimothyEdwards/sg13cmos5l_ocd_openframe/scripts/sg13cmos5l_padframe_template.v

/*-----------------------------------------------------------------------*/
/* sg13cmos5l_padframe:  A 64-pad frame compatible with Efabless Caravel */
/*									 */
/* Written by:								 */
/* Tim Edwards								 */
/* Open Circuit Design, LLC						 */
/* February 2026							 */
/*-----------------------------------------------------------------------*/

TEMPLATE_MESSAGE

`default_nettype none

module sg13cmos5l_padframe (
`ifdef USE_POWER_PINS
    // Pad power connections
    inout wire vccd,
    inout wire vssd,
    inout wire vddio,
    inout wire vssio,
`endif	/* USE_POWER_PINS */

    // Pad signal connections
    inout wire [43:0] gpio,
    input wire resetb,
    input wire clock,
    input wire option,

    // Core signal connections
    INPUT_OUTPUT_LIST

    // Core signal connections:  User ID ROM
    output wire [31:0] mask_rev
);

    // Instantiate the pads:

    // Corner pads

    sg13cmos5l_Corner corner_sw (
	`ifdef USE_POWER_PINS
	    .iovdd(vddio),
	    .iovss(vssio),
	    .vdd(vccd),
	    .vss(vssd)
	`endif	/* USE_POWER_PINS */
    );

    sg13cmos5l_Corner corner_se (
	`ifdef USE_POWER_PINS
	    .iovdd(vddio),
	    .iovss(vssio),
	    .vdd(vccd),
	    .vss(vssd)
	`endif	/* USE_POWER_PINS */
    );

    sg13cmos5l_Corner corner_nw (
	`ifdef USE_POWER_PINS
	    .iovdd(vddio),
	    .iovss(vssio),
	    .vdd(vccd),
	    .vss(vssd)
	`endif	/* USE_POWER_PINS */
    );

    sg13cmos5l_Corner corner_ne (
	`ifdef USE_POWER_PINS
	    .iovdd(vddio),
	    .iovss(vssio),
	    .vdd(vccd),
	    .vss(vssd)
	`endif	/* USE_POWER_PINS */
    );

    // Bottom side pads

    sg13cmos5l_IOPadVdd pad_vccd_0 (
	`ifdef USE_POWER_PINS
	    .iovdd(vddio),
	    .iovss(vssio),
	    .vdd(vccd),
	    .vss(vssd)
	`endif	/* USE_POWER_PINS */
    );

    sg13cmos5l_IOPadVss pad_vssio_0 (
	`ifdef USE_POWER_PINS
	    .iovdd(vddio),
	    .iovss(vssio),
	    .vdd(vccd),
	    .vss(vssd)
	`endif	/* USE_POWER_PINS */
    );

    sg13cmos5l_IOPadIn pad_resetb (
	`ifdef USE_POWER_PINS
	    .iovdd(vddio),
	    .iovss(vssio),
	    .vdd(vccd),
	    .vss(vssd),
	`endif	/* USE_POWER_PINS */
	.pad(resetb),
	.p2c(resetb_in)
    );

    PAD_38_TYPE pad_gpio_38 (
	`ifdef USE_POWER_PINS
	    .iovdd(vddio),
	    .iovss(vssio),
	    .vdd(vccd),
	    .vss(vssd),
	`endif	/* USE_POWER_PINS */
	.pad(gpio[38]),
	PAD_38_SIGNALS
    );

    sg13cmos5l_IOPadVss pad_vssd_0 (
	`ifdef USE_POWER_PINS
	    .iovdd(vddio),
	    .iovss(vssio),
	    .vdd(vccd),
	    .vss(vssd)
	`endif	/* USE_POWER_PINS */
    );

    PAD_39_TYPE pad_gpio_39 (
	`ifdef USE_POWER_PINS
	    .iovdd(vddio),
	    .iovss(vssio),
	    .vdd(vccd),
	    .vss(vssd),
	`endif	/* USE_POWER_PINS */
	.pad(gpio[39]),
	PAD_39_SIGNALS
    );

    PAD_40_TYPE pad_gpio_40 (
	`ifdef USE_POWER_PINS
	    .iovdd(vddio),
	    .iovss(vssio),
	    .vdd(vccd),
	    .vss(vssd),
	`endif	/* USE_POWER_PINS */
	.pad(gpio[40]),
	PAD_40_SIGNALS
    );

    PAD_41_TYPE pad_gpio_41 (
	`ifdef USE_POWER_PINS
	    .iovdd(vddio),
	    .iovss(vssio),
	    .vdd(vccd),
	    .vss(vssd),
	`endif	/* USE_POWER_PINS */
	.pad(gpio[41]),
	PAD_41_SIGNALS
    );

    PAD_42_TYPE pad_gpio_42 (
	`ifdef USE_POWER_PINS
	    .iovdd(vddio),
	    .iovss(vssio),
	    .vdd(vccd),
	    .vss(vssd),
	`endif	/* USE_POWER_PINS */
	.pad(gpio[42]),
	PAD_42_SIGNALS
    );

    PAD_43_TYPE pad_gpio_43 (
	`ifdef USE_POWER_PINS
	    .iovdd(vddio),
	    .iovss(vssio),
	    .vdd(vccd),
	    .vss(vssd),
	`endif	/* USE_POWER_PINS */
	.pad(gpio[43]),
	PAD_43_SIGNALS
    );

    sg13cmos5l_IOPadIOVss pad_vssio_1 (
	`ifdef USE_POWER_PINS
	    .iovdd(vddio),
	    .iovss(vssio),
	    .vdd(vccd),
	    .vss(vssd)
	`endif	/* USE_POWER_PINS */
    );

    sg13cmos5l_IOPadIOVdd pad_vddio_0 (
	`ifdef USE_POWER_PINS
	    .iovdd(vddio),
	    .iovss(vssio),
	    .vdd(vccd),
	    .vss(vssd)
	`endif	/* USE_POWER_PINS */
    );

    // Right side pads

    PAD_0_TYPE pad_gpio_0 (
	`ifdef USE_POWER_PINS
	    .iovdd(vddio),
	    .iovss(vssio),
	    .vdd(vccd),
	    .vss(vssd),
	`endif	/* USE_POWER_PINS */
	.pad(gpio[0]),
	PAD_0_SIGNALS
    );

    PAD_1_TYPE pad_gpio_1 (
	`ifdef USE_POWER_PINS
	    .iovdd(vddio),
	    .iovss(vssio),
	    .vdd(vccd),
	    .vss(vssd),
	`endif	/* USE_POWER_PINS */
	.pad(gpio[1]),
	PAD_1_SIGNALS
    );

    PAD_2_TYPE pad_gpio_2 (
	`ifdef USE_POWER_PINS
	    .iovdd(vddio),
	    .iovss(vssio),
	    .vdd(vccd),
	    .vss(vssd),
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
    user_id_textblock user_id_textblock ();
    open_source open_source ();

    /* Add in user_id_programming (32-bit ROM block) */

    user_id_programming user_id_programming (
	`ifdef USE_POWER_PINS
	    .VDD(vccd),
	    .VSS(vssd),
	`endif  /* USE_POWER_PINS */
	.mask_rev(mask_rev)
    );

    /* Add in constant blocks (digital 1/0 near each digital pad) */

   CONSTANT_BLOCKS

endmodule

`default_nettype wire
