RTimothyEdwards/sg13cmos5l_ocd_openframe/scripts/tech_change.py

#!/bin/env python3
#
# tech_change.py ---
#
# Changes the technology in all .mag files in a directory to
# "ihp-sg13cmod5l".  This is simpler than running magic and doing a
# 'load -force' and rewriting each layout file, although this method
# does not update timestamps.

import glob
import sys

files = glob.glob('*.mag')
modified = False

for file in files:
    with open(file, 'r') as ifile:
        lines = ifile.read().splitlines()

    newlines = []
    for line in lines:
        key = line.split()[0]
        if key == 'tech':
            newlines.append('tech ihp-sg13cmos5l')
            if line.split()[1] != 'ihp-sg13cmos5l':
                modified = True
        else:
            newlines.append(line)

    if modified:
        print('Overwriting: ' + file)
        with open(file, 'w') as ofile:
            for line in newlines:
                print(line, file=ofile)

sys.exit(0)
