RTimothyEdwards/sg13cmos5l_ocd_openframe/(commit log)

2026-03-12 Initial commit of files for sg13cmos5l_ocd_openframe, a Caravel-compatible "open frame" harness design for IHP SG13CMOS5L.
2026-03-29 Main push of files for the IHP test tapeout of the openframe example with analog test components.
    [openframe_user_project.sch]
2026-03-30 One-day overhaul. Did the following: (1) Wrote the netlists and netlisting/LVS scripts to handle the layout all the way up to the final top level. (2) Ran and tested the user ID setting (3) Finished 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
    [openframe_user_project.sch]
2026-03-31 Added a configuration file that allows a user to specify the type of pad used for each of the 44 GPIO pins. This has been a long-term goal to avoid the problem of the original Efabless Caravel that t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
    [config.txt]
